cmonr/Robotics-BoosterPack/README.md

Robotics-BoosterPack
====================

Robotics BoosterPack for the Tiva Launchpad

For lack of a better place, the Mouser BoM: 
[Mouser BoM](http://www.mouser.com/ProjectManager/ProjectDetail.aspx?AccessID=04738dc8be)
