cmonr/Robotics-BoosterPack/schematic.png

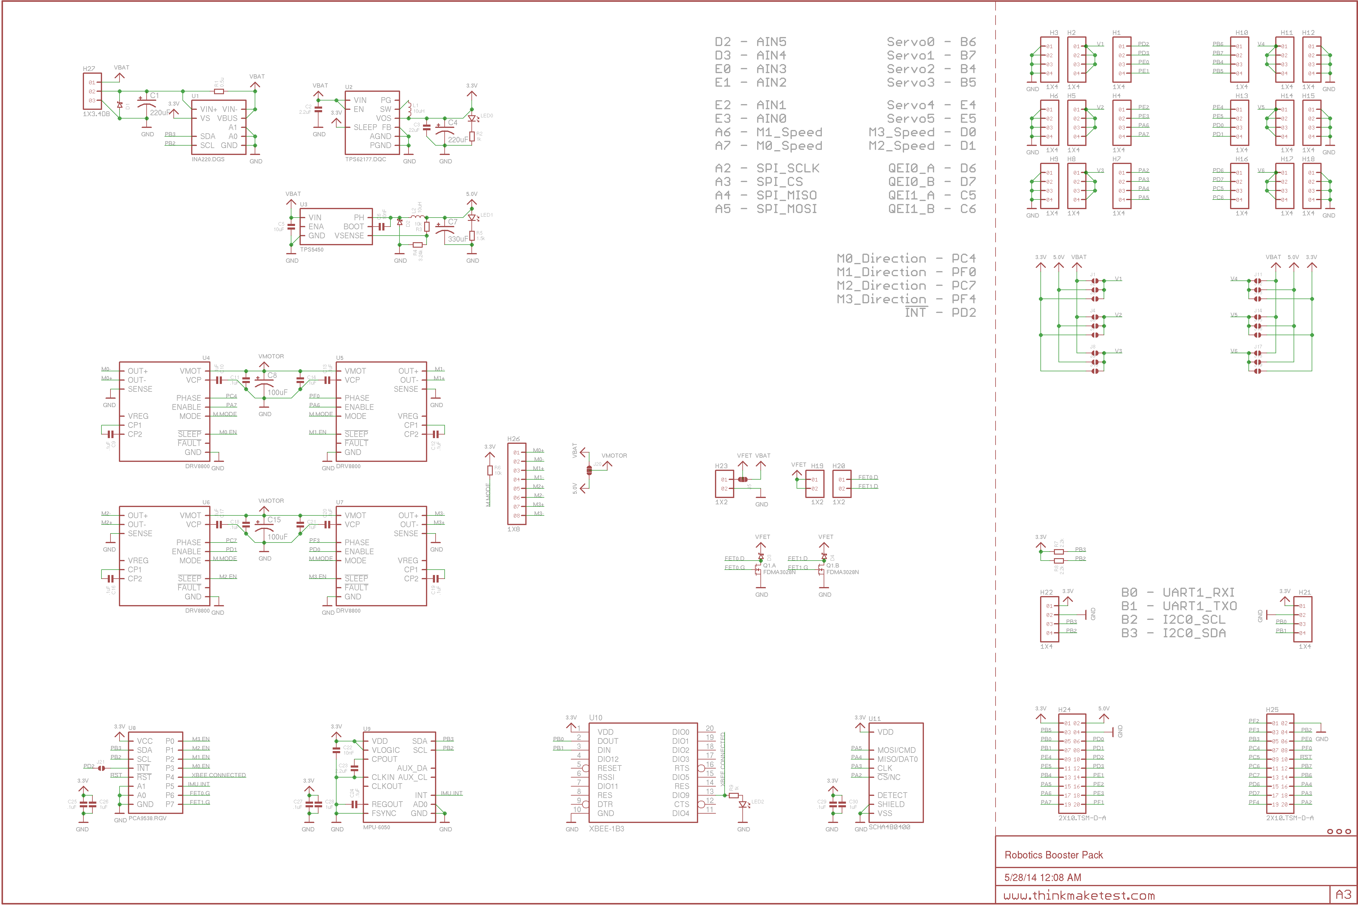
schematic.png
