cmonr/Robotics-BoosterPack/Robotics Booster Pack.dxf

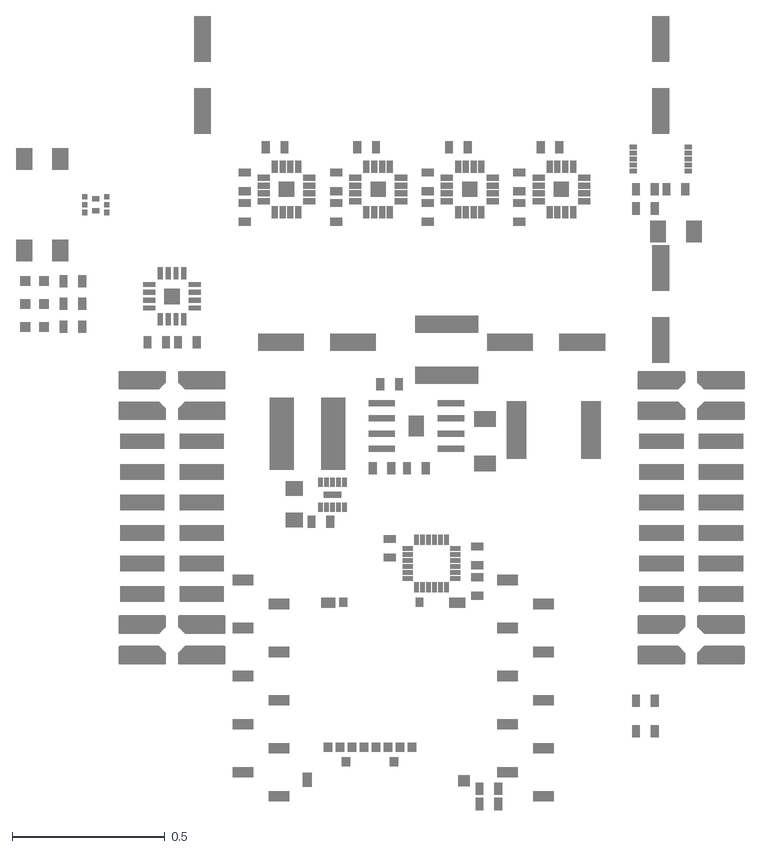
[picture p2: CAD file, 2014-06-07]
Robotics Booster Pack.dxf
2.38 x 2.60
