cmonr/Robotics-BoosterPack/Robotics Booster Pack.brd

## EAGLE design Robotics Booster Pack.brd (2014-05-28)

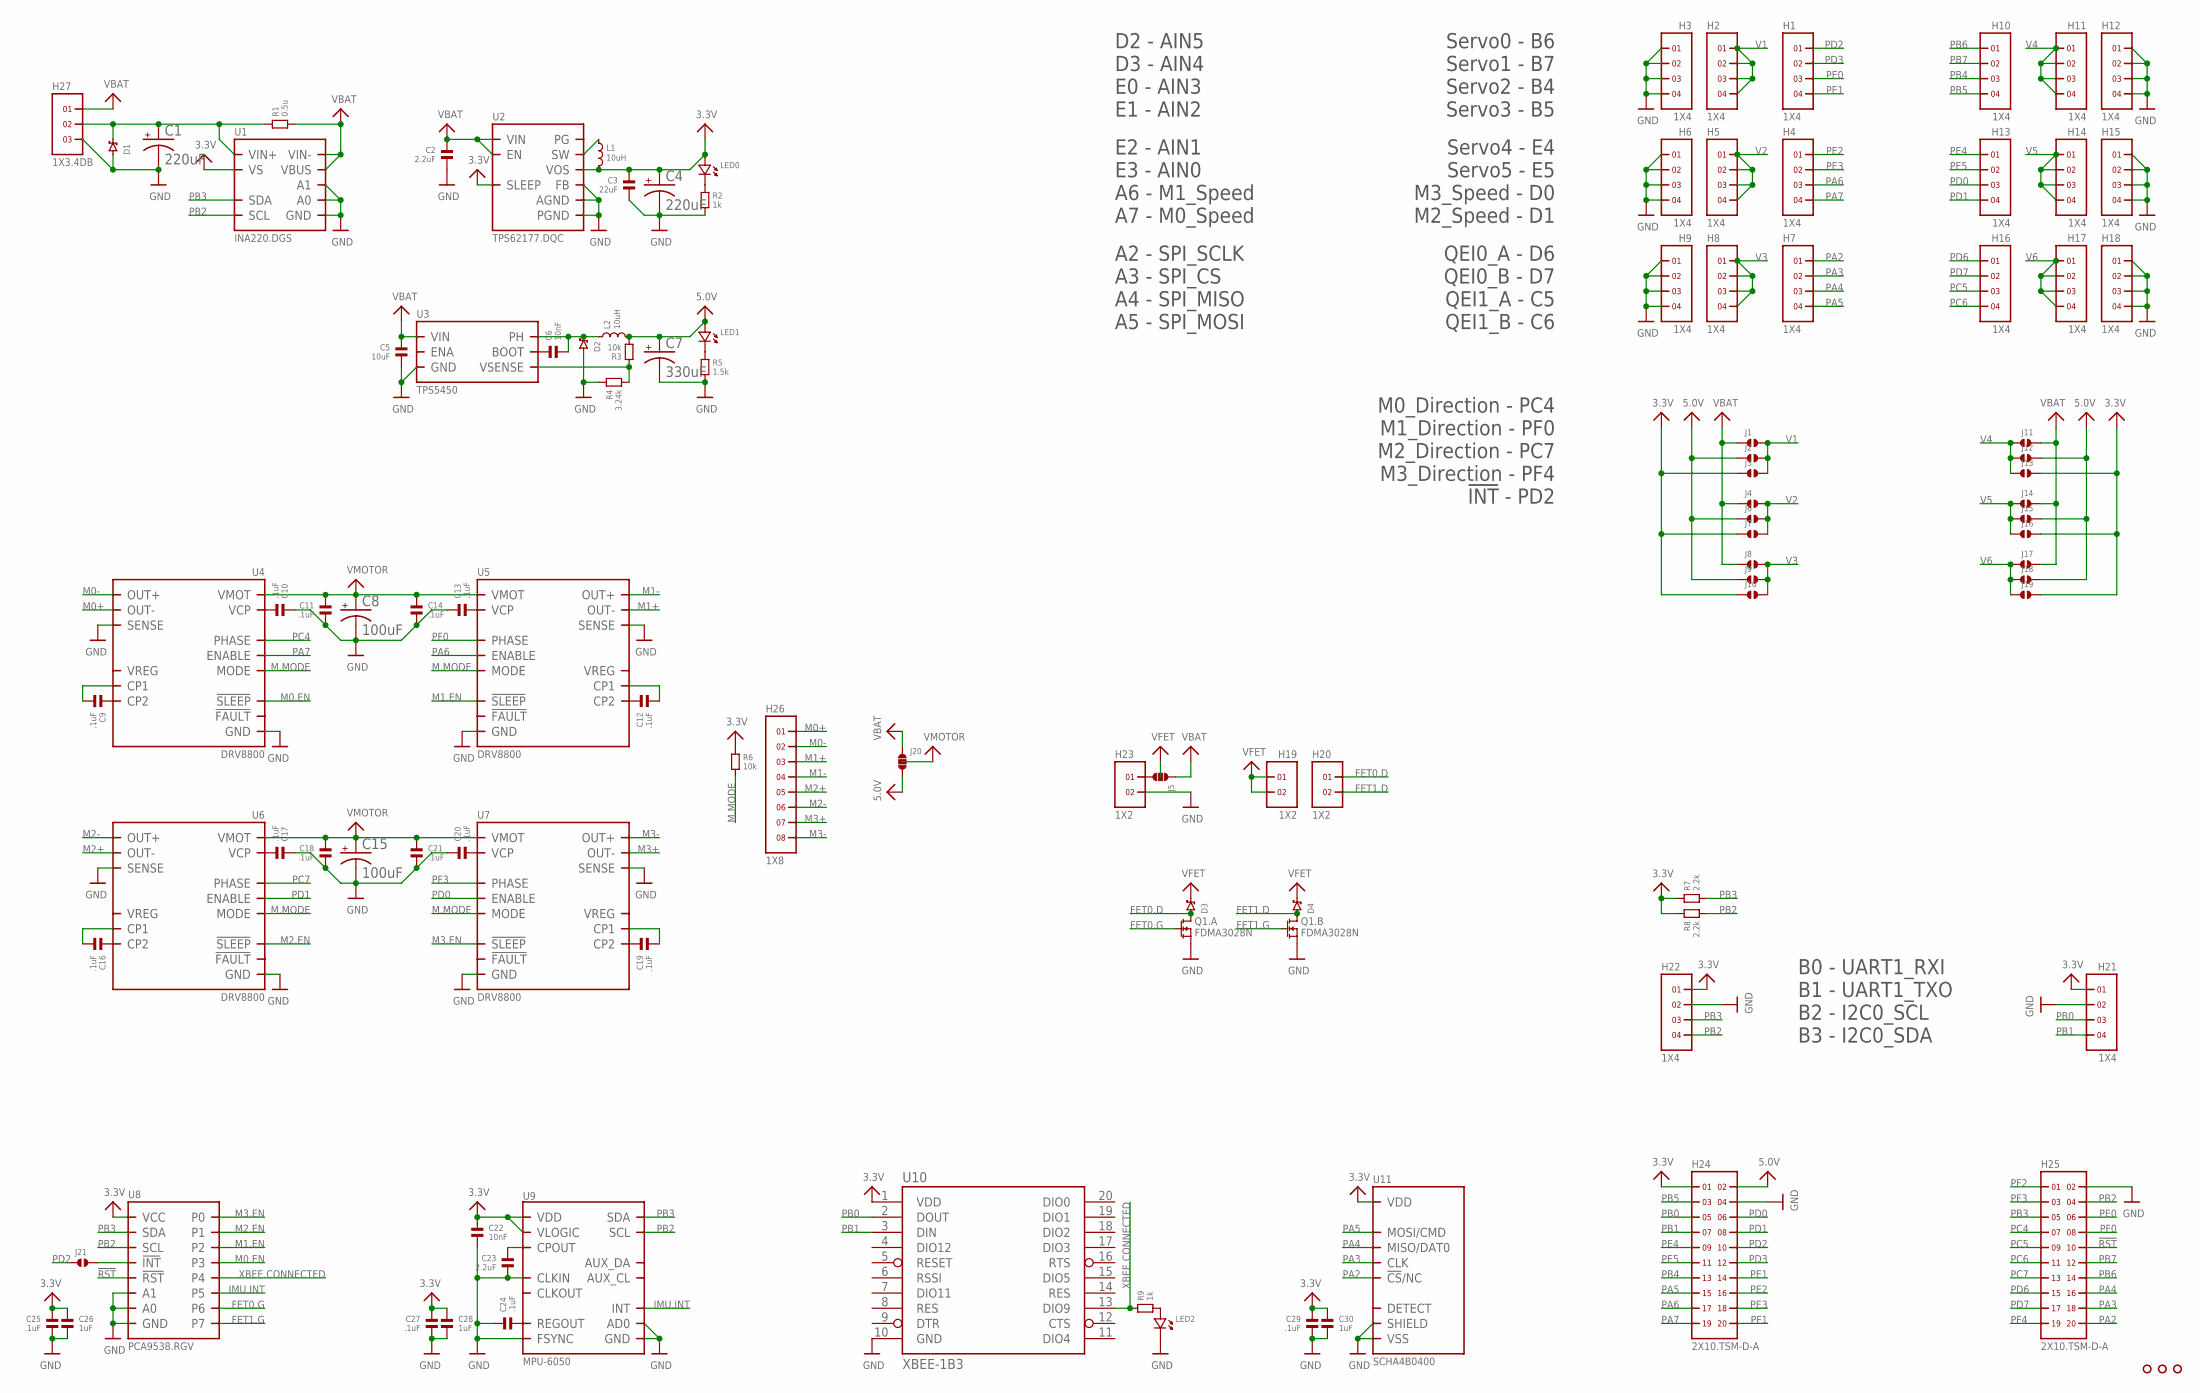
[picture p3: schematic Robotics Booster Pack.sch]

Parts:
C1, C4: 220uF; PANASONIC_E
C2, C23: 2.2uF; 0603
C3: 22uF; 0805
C5: 10uF; 1206
C6, C22: 10nF; 0603
C7: 330uF; PANASONIC_E
C8, C15: 100uF; PANASONIC_E
C9, C10, C11, C12, C13, C14, C16, C17, C18, C19, C20, C21, C24, C25, C27, C29: .1uF; 0603
C26, C28, C30: 1uF; 0603
D1, D3, D4: CDBMT2100-HF; SOD-123H
D2: CDBC5XXX-G; DO-214AB
H1, H2, H3, H4, H5, H6, H7, H8, H9, H10, H11, H12, H13, H14, H15, H16, H17, H18, H21, H22: 1X4
H19, H20, H23: 1X2
H24, H25: 2X10.TSM-D-A; TSM-110-XX-XXX-DV-A
H26: 1X8; 1824480000
H27: 1X3.4DB; 4DB-P108-02
J1, J2, J4, J6, J8, J9, J11, J13, J14, J15, J17, J18, J21: SOLDERJUMPER.2.LRG; 2.LRG
J3, J7, J10, J12, J16, J19: SOLDERJUMPER.2.LRG.PASTE; 2.LRG.PASTE
J5, J20: SOLDERJUMPER.3.LRG.12; 3.LRG.12
L1: 10uH; SRN6045
L2: 10uH; XAL6060
LED0, LED1, LED2: LED.0603; 0603.LED
Q1: FDMA3028N; MICROFET.2X2
R1: 0.5u; 2512
R2, R9: 1k; 0603
R3, R6: 10k; 0603
R4: 3.24k; 0603
R5: 1.5k; 0603
R7, R8: 2.2k; 0603
U1: INA220.DGS; DGS.10
U2: TPS62177.DQC; DQC
U3: TPS5450; DDA
U4, U5, U6, U7: DRV8800; RTY.16
U8: PCA9538.RGV; RGV.16
U9: MPU-6050; QFN.24.4X4
U10: XBEE-1B3; XBEE-SMD
U11: SCHA4B0400
U$3, U$4, U$21: HOLE.4MM; #4

Connections:
3.3V: C3.1, C4.+, C22.1, C25.1, C26.1, C27.1, C28.1, C29.1, C30.1, H21.1, H22.1, H24.1, J3.1, J7.1, J10.1, J13.1, J16.1, J19.1, L1.2, LED0.P$1 (1), R6.1, R7.1, R8.1, U1.6 (VS), U2.8 (SLEEP), U2.10 (VOS), U8.14 (VCC), U9.8 (VLOGIC), U9.13 (VDD), U10.1 (VDD), U11.VDD
5.0V: C7.+, H24.2, J2.1, J6.1, J9.1, J12.1, J15.1, J18.1, J20.3, L2.2, LED1.P$1 (1), R3.2
!RST: H25.10, U8.1 (!RST)
FET0.D: D3.2, H20.1, Q1.6 (D), Q1.PAD@1 (D)
FET0.G: Q1.2 (G), U8.9 (P6)
FET1.D: D4.2, H20.2, Q1.3 (D), Q1.PAD@2 (D)
FET1.G: Q1.5 (G), U8.10 (P7)
GND: C1.-, C2.2, C3.2, C4.-, C5.2, C7.-, C8.-, C10.1, C11.2, C13.1, C14.2, C15.-, C17.1, C18.2, C20.1, C21.2, C22.2, C23.2, C24.1, C25.2, C26.2, C27.2, C28.2, C29.2, C30.2, D1.2, D2.2, H3.1, H3.2, H3.3, H3.4, H6.1, H6.2, H6.3, H6.4, H9.1, H9.2, H9.3, H9.4, H12.1, H12.2, H12.3, H12.4, H15.1, H15.2, H15.3, H15.4, H18.1, H18.2, H18.3, H18.4, H21.2, H22.2, H23.2, H24.4, H25.2, H27.3, LED2.P$2 (2), Q1.1 (S), Q1.4 (S), R2.2, R4.1, R5.2, U1.1 (A1), U1.2 (A0), U1.7 (GND), U2.1 (PGND), U2.5 (FB), U2.6 (AGND), U2.PAD (PGND), U3.6 (GND), U3.PAD (GND), U4.2 (GND), U4.7 (SENSE), U4.12 (GND), U4.PAD (GND), U5.2 (GND), U5.7 (SENSE), U5.12 (GND), U5.PAD (GND), U6.2 (GND), U6.7 (SENSE), U6.12 (GND), U6.PAD (GND), U7.2 (GND), U7.7 (SENSE), U7.12 (GND), U7.PAD (GND), U8.6 (GND), U8.15 (A0), U8.16 (A1), U8.PAD (GND), U9.1 (CLKIN), U9.9 (AD0), U9.11 (FSYNC), U9.18 (GND), U10.10 (GND), U11.GND (VSS), U11.GND@1 (VSS), U11.GND@2 (VSS), U11.SHIELD, U11.SHIELD@1 (SHIELD), U11.SHIELD@2 (SHIELD), U11.SHIELD@3 (SHIELD), U11.VSS
IMU.INT: U8.8 (P5), U9.12 (INT)
M0+: H26.1@1 (1), H26.1@2 (1), U4.9 (OUT-)
M0-: H26.2@1 (2), H26.2@2 (2), U4.6 (OUT+)
M0.EN: U4.3 (!SLEEP), U8.5 (P3)
M1+: H26.3@1 (3), H26.3@2 (3), U5.9 (OUT-)
M1-: H26.4@1 (4), H26.4@2 (4), U5.6 (OUT+)
M1.EN: U5.3 (!SLEEP), U8.4 (P2)
M2+: H26.5@1 (5), H26.5@2 (5), U6.9 (OUT-)
M2-: H26.6@1 (6), H26.6@2 (6), U6.6 (OUT+)
M2.EN: U6.3 (!SLEEP), U8.3 (P1)
M3+: H26.7@1 (7), H26.7@2 (7), U7.9 (OUT-)
M3-: H26.8@1 (8), H26.8@2 (8), U7.6 (OUT+)
M3.EN: U7.3 (!SLEEP), U8.2 (P0)
M.MODE: R6.2, U4.16 (MODE), U5.16 (MODE), U6.16 (MODE), U7.16 (MODE)
unnamed: L1.1, U2.9 (SW)
unnamed: LED0.P$2 (2), R2.1
unnamed: LED1.P$2 (2), R5.1
unnamed: LED2.P$1 (1), R9.2
unnamed: H23.1, J5.3
unnamed: C24.2, U9.10 (REGOUT)
unnamed: J21.2, U8.11 (!INT)
unnamed: C9.1, U4.11 (CP2)
unnamed: C10.2, U4.13 (VCP)
unnamed: C13.2, U5.13 (VCP)
unnamed: C17.2, U6.13 (VCP)
unnamed: C20.2, U7.13 (VCP)
unnamed: C1.+, D1.1, H27.2, R1.1, U1.10 (VIN+)
unnamed: C23.1, U9.20 (CPOUT)
unnamed: C12.1, U5.11 (CP2)
unnamed: C16.1, U6.11 (CP2)
unnamed: C19.1, U7.11 (CP2)
unnamed: C6.1, U3.1 (BOOT)
unnamed: C6.2, D2.1, L2.1, U3.8 (PH)
unnamed: R3.1, R4.2, U3.4 (VSENSE)
unnamed: C16.2, U6.10 (CP1)
unnamed: C9.2, U4.10 (CP1)
unnamed: C12.2, U5.10 (CP1)
unnamed: C19.2, U7.10 (CP1)
PA2: H7.1, H25.20, U11.!CS!/NC/DAT3 (!CS!/NC)
PA3: H7.2, H25.18, U11.CLK
PA4: H7.3, H25.16, U11.MISO/DAT0
PA5: H7.4, H24.15, U11.MOSI/CMD
PA6: H4.3, H24.17, U5.4 (ENABLE)
PA7: H4.4, H24.19, U4.4 (ENABLE)
PB0: H21.3, H24.5, U10.2 (DOUT)
PB1: H21.4, H24.7, U10.3 (DIN)
PB2: H22.4, H25.4, R8.2, U1.5 (SCL), U8.12 (SCL), U9.23 (SCL)
PB3: H22.3, H25.5, R7.2, U1.4 (SDA), U8.13 (SDA), U9.24 (SDA)
PB4: H10.3, H24.13
PB5: H10.4, H24.3
PB6: H10.1, H25.14
PB7: H10.2, H25.12
PC4: H25.7, U4.1 (PHASE)
PC5: H16.3, H25.9
PC6: H16.4, H25.11
PC7: H25.13, U6.1 (PHASE)
PD0: H13.3, H24.6, U7.4 (ENABLE)
PD1: H13.4, H24.8, U6.4 (ENABLE)
PD2: H1.1, H24.10, J21.1
PD3: H1.2, H24.12
PD6: H16.1, H25.15
PD7: H16.2, H25.17
PE0: H1.3, H25.6
PE1: H1.4, H24.14
PE2: H4.1, H24.16
PE3: H4.2, H24.18
PE4: H13.1, H24.9
PE5: H13.2, H24.11
PF0: H25.8, U5.1 (PHASE)
PF1: H24.20
PF2: H25.1
PF3: H25.3, U7.1 (PHASE)
PF4: H25.19
V1: H2.1, H2.2, H2.3, H2.4, J1.2, J2.2, J3.2
V2: H5.1, H5.2, H5.3, H5.4, J4.2, J6.2, J7.2
V3: H8.1, H8.2, H8.3, H8.4, J8.2, J9.2, J10.2
V4: H11.1, H11.2, H11.3, H11.4, J11.2, J12.2, J13.2
V5: H14.1, H14.2, H14.3, H14.4, J14.2, J15.2, J16.2
V6: H17.1, H17.2, H17.3, H17.4, J17.2, J18.2, J19.2
VBAT: C2.1, C5.1, H27.1, J1.1, J4.1, J5.1, J8.1, J11.1, J14.1, J17.1, J20.1, R1.2, U1.8 (VBUS), U1.9 (VIN-), U2.2 (VIN), U2.3 (EN), U3.7 (VIN)
VFET: D3.1, D4.1, H19.1, H19.2, J5.2
VMOTOR: C8.+, C11.1, C14.1, C15.+, C18.1, C21.1, J20.2, U4.8 (VMOT), U5.8 (VMOT), U6.8 (VMOT), U7.8 (VMOT)
XBEE.CONNECTED: R9.1, U8.7 (P4), U10.13 (DIO9)

Notes on the sheet:
D2 - AIN5 D3 - AIN4 E0 - AIN3 E1 - AIN2
E2 - AIN1 E3 - AIN0 A6 - M1_Speed A7 - M0_Speed
A2 - SPI_SCLK A3 - SPI_CS A4 - SPI_MISO A5 - SPI_MOSI
Servo0 - B6 Servo1 - B7 Servo2 - B4 Servo3 - B5
Servo4 - E4 Servo5 - E5 M3_Speed - D0 M2_Speed - D1
QEI0_A - D6 QEI0_B - D7 QEI1_A - C5 QEI1_B - C6
B0 - UART1_RXI B1 - UART1_TXO B2 - I2C0_SCL B3 - I2C0_SDA
M0_Direction - PC4 M1_Direction - PF0 M2_Direction - PC7 M3_Direction - PF4 !INT! - PD2

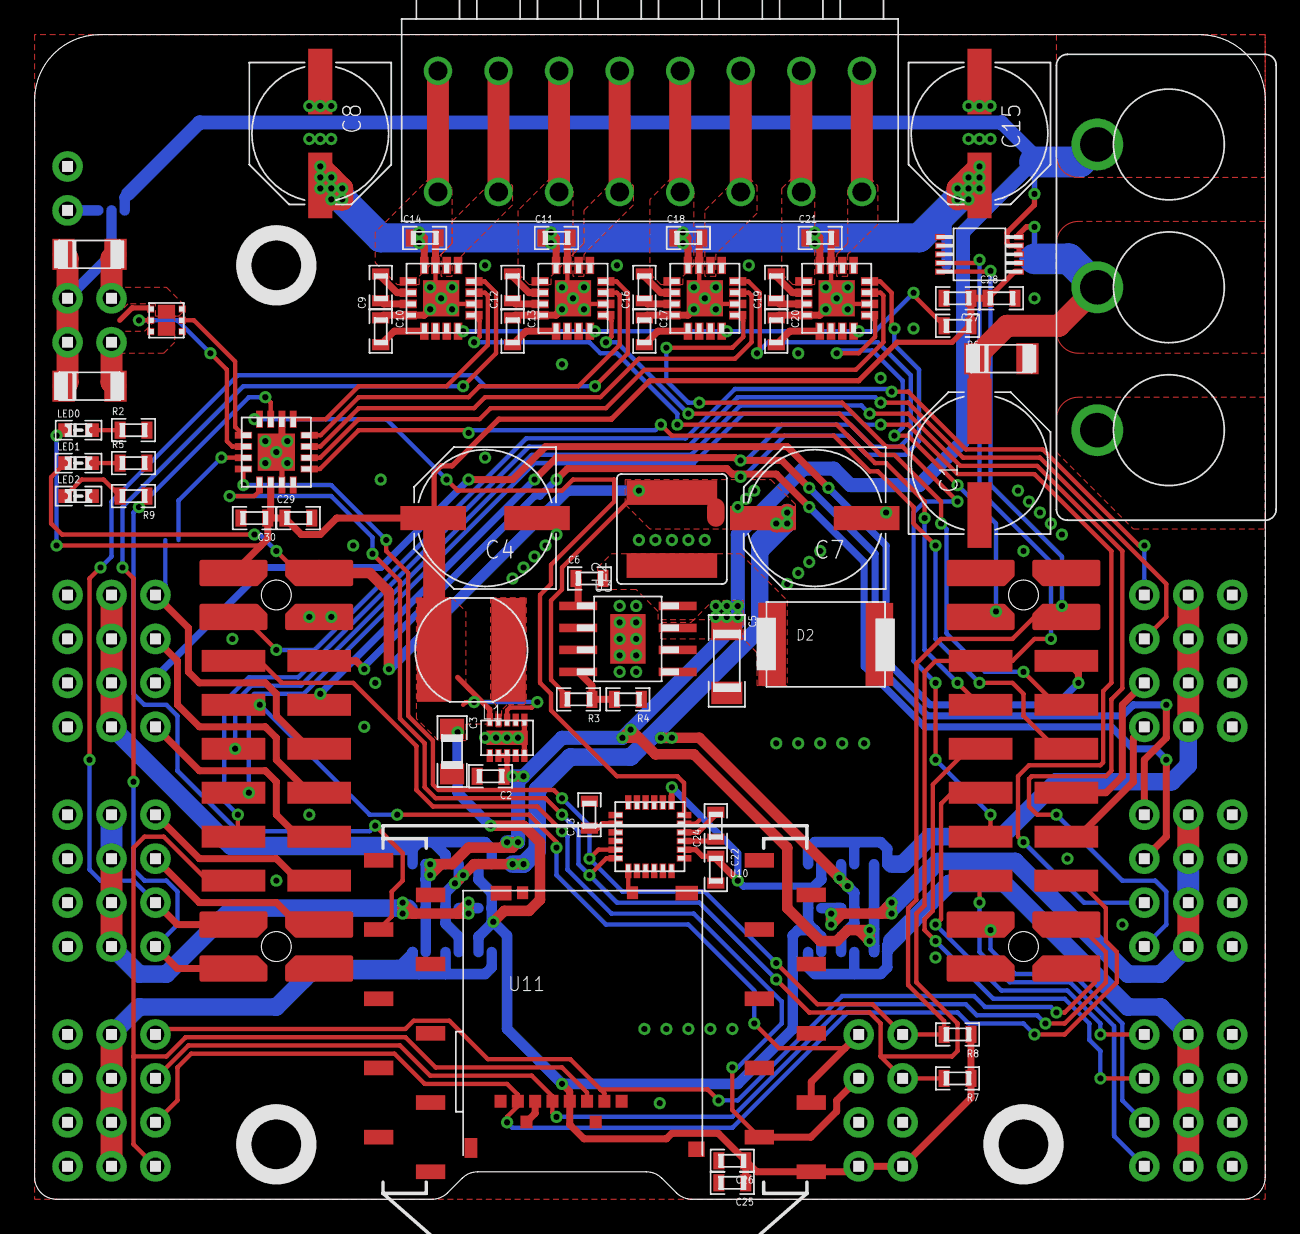
[picture p4: board Robotics Booster Pack.brd from above]

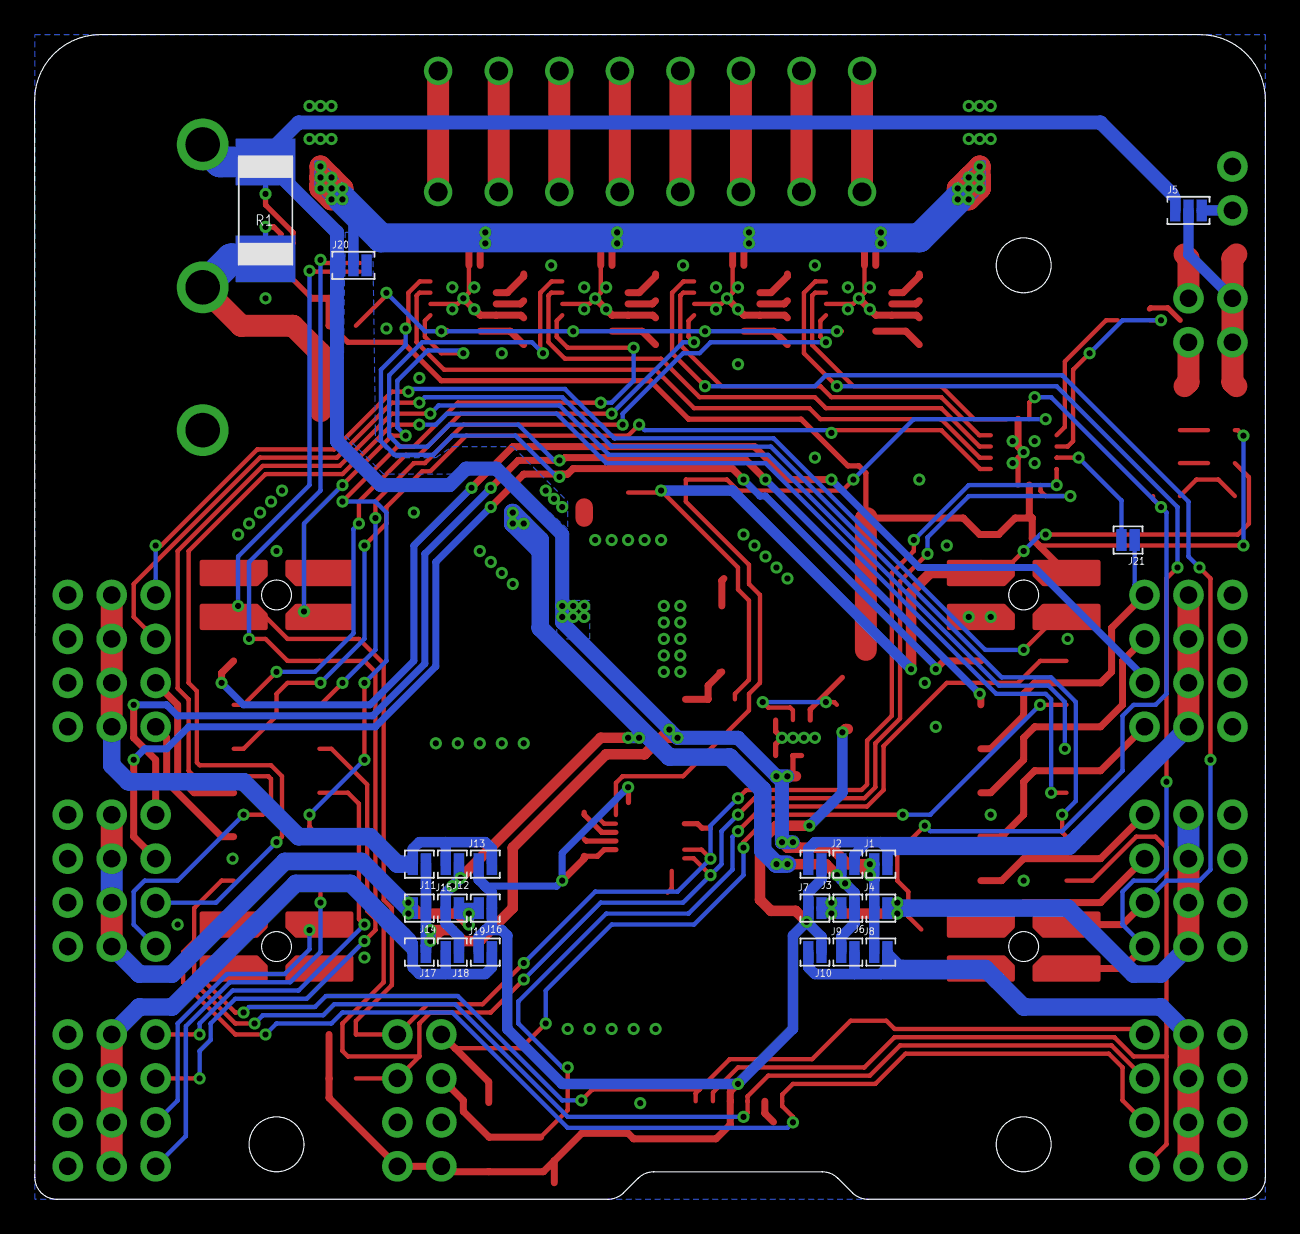
[picture p5: board Robotics Booster Pack.brd from below]

Board: 2 copper layers, 71.1 x 67.3 mm, 111 parts (22 on the bottom side), 88 nets.
