cmonr/Robotics-BoosterPack/Robot Board ++.brd

## EAGLE design Robot Board ++.brd (2013-05-02)

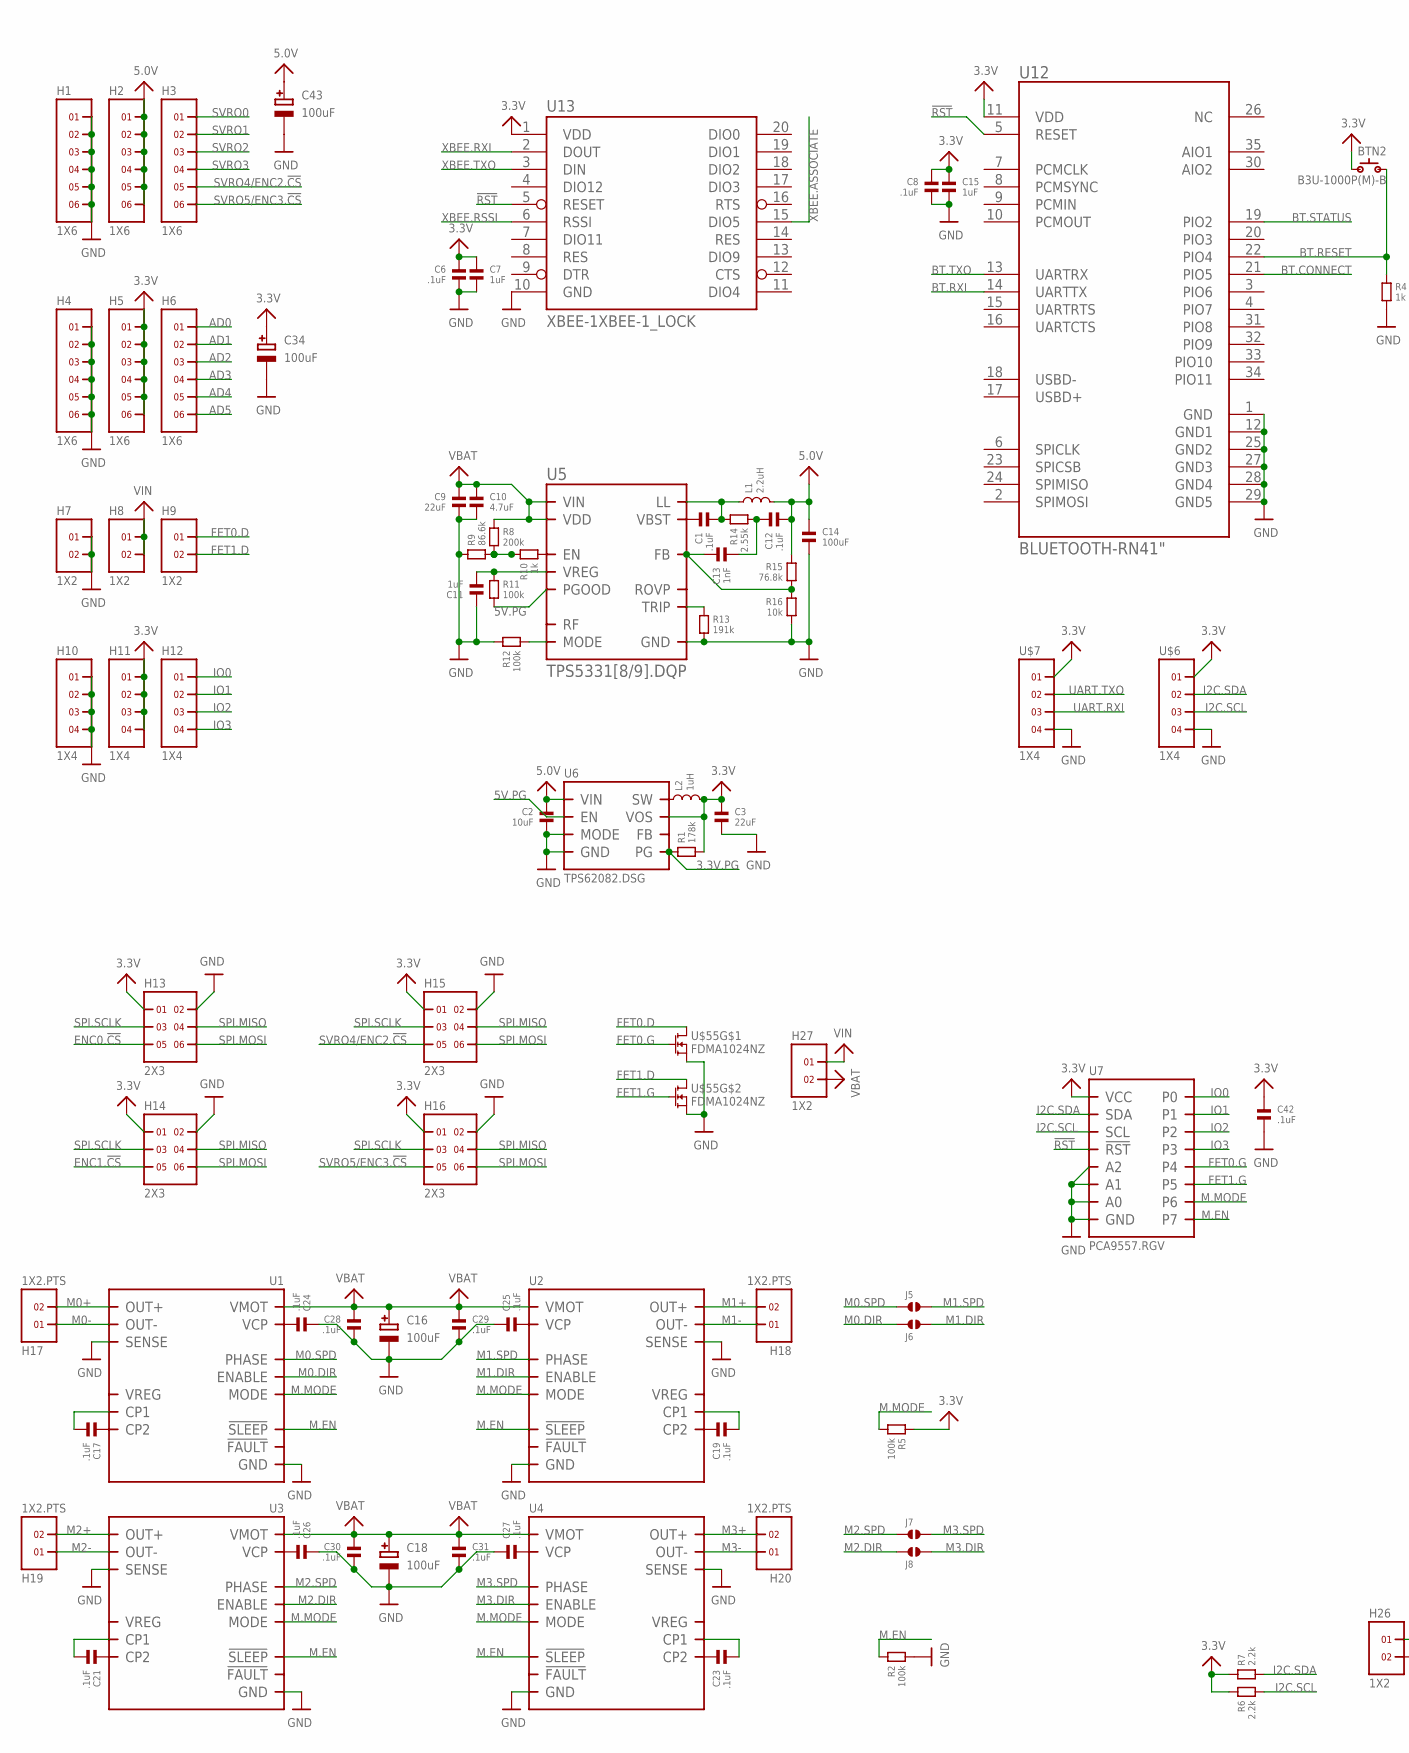
[picture p6: schematic Robot Board ++.sch, part in row 1, column 1]

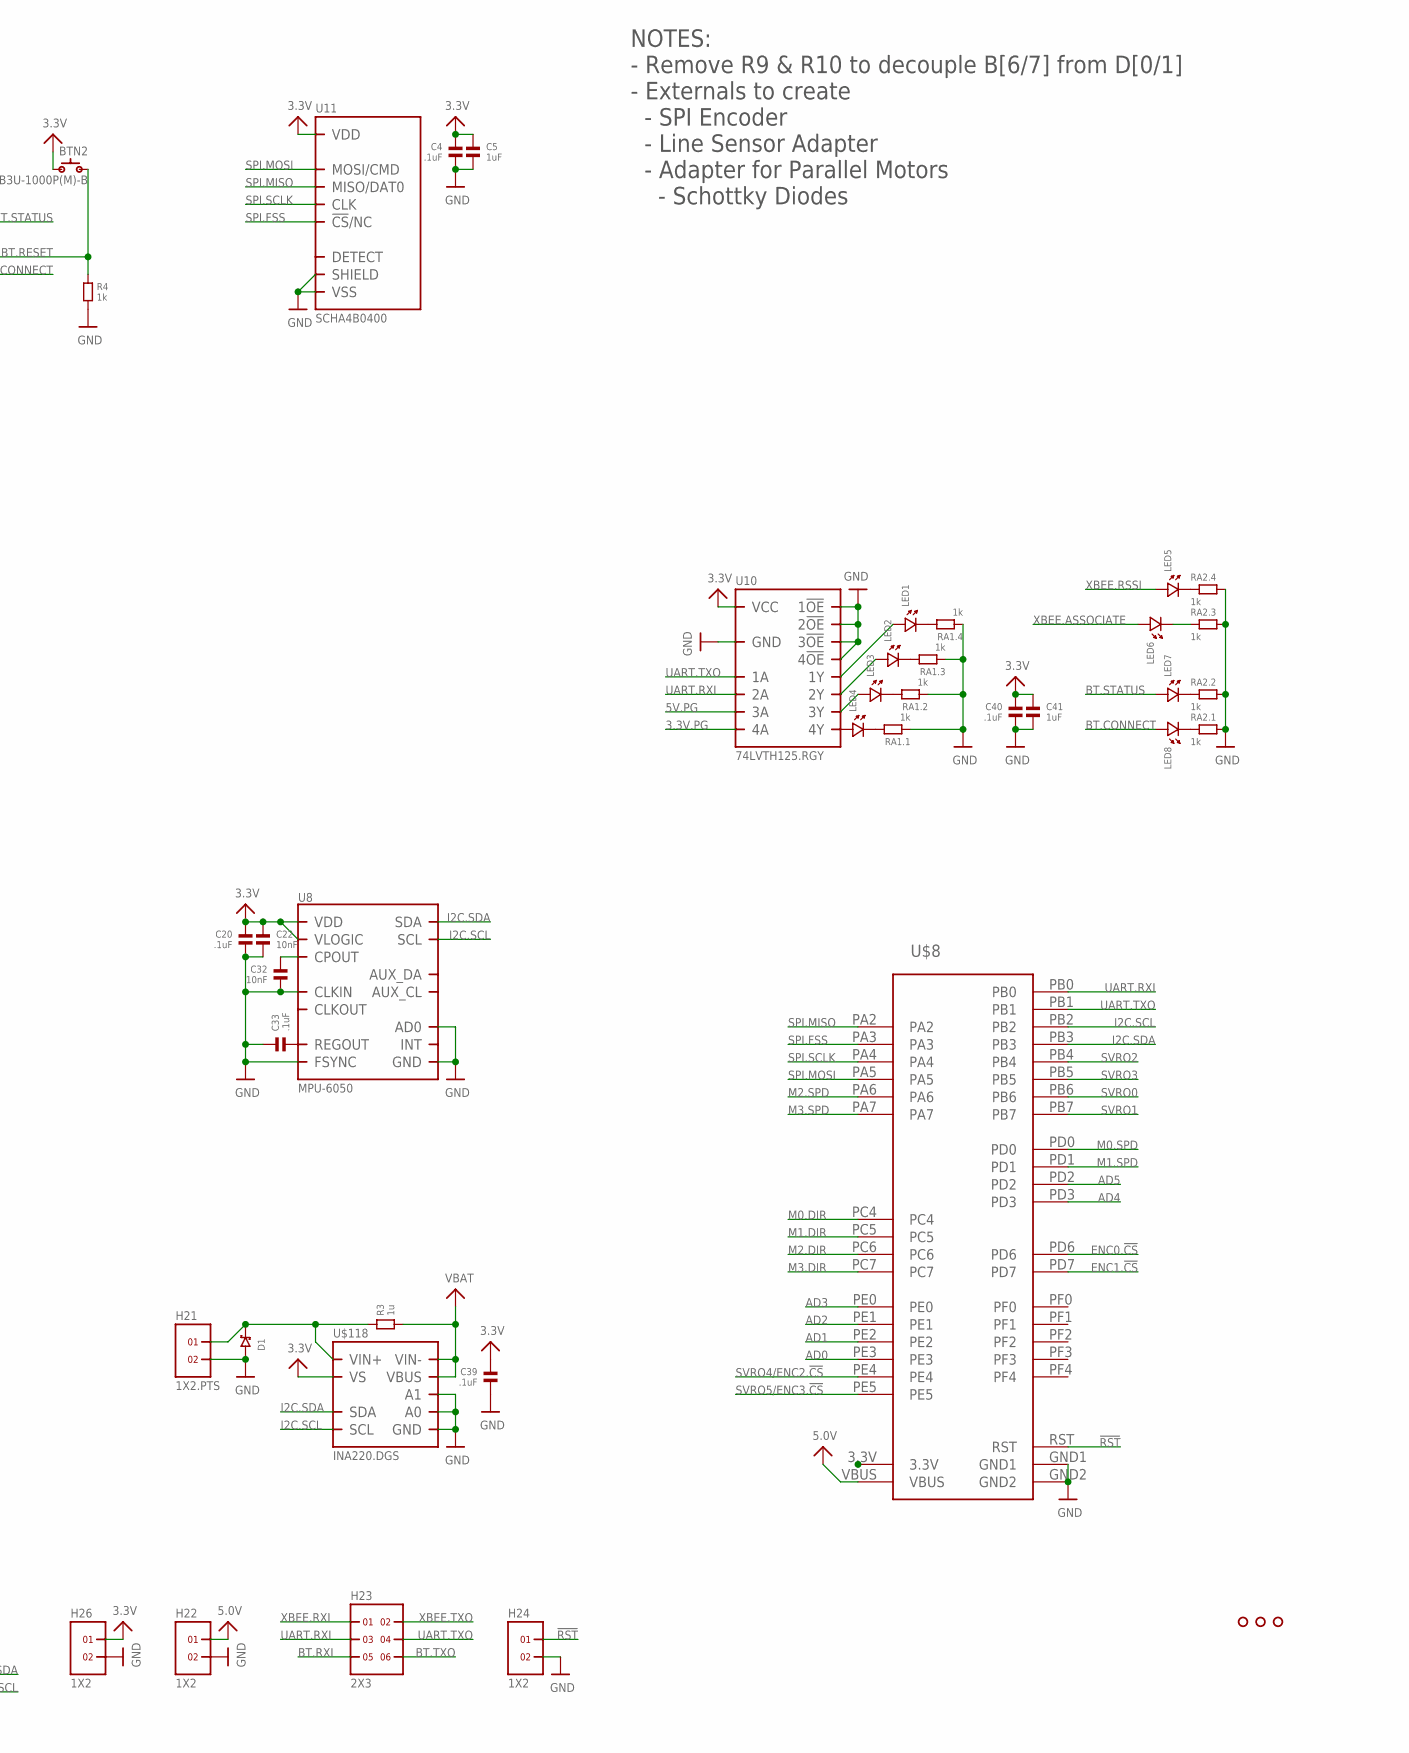
[picture p7: schematic Robot Board ++.sch, part in row 1, column 2]

Parts:
BTN2: B3U-1000P(M)-B
C1, C4, C6, C8, C12, C17, C19, C20, C21, C23, C24, C25, C26, C27, C28, C29, C30, C31, C33, C39, C40, C42: .1uF; 0603
C2: 10uF; 0603
C3: 22uF; 0603
C5, C7, C11, C15, C41: 1uF; 0603
C9: 22uF; 1206
C10: 4.7uF; 0805
C13: 1nF; 0603
C14: 100uF; 1210
C16, C18, C34, C43: 100uF; PANASONIC_C
C22, C32: 10nF; 0603
D1: DIODE[SCHOTKY]-SOD123W; SOD123W
H1, H2, H3, H4, H5, H6: 1X6
H7, H8, H9, H22, H24, H26, H27: 1X2
H10, H11, H12: 1X4
H13, H14, H15, H16: 2X3; 2X3@1
H17, H18, H19, H20, H21: 1X2.PTS; PTS.PLUG
H23: 2X3
J5, J6, J7, J8: SOLDERJUMPER.2.LRG; 2.LRG
L1: 2.2uH; XAL6030
L2: 1uH; SRN3015
LED1, LED2, LED3, LED4, LED5, LED6, LED7, LED8: LED.0603; 0603.LED
R1: 178k; 0603
R2, R5, R11, R12: 100k; 0603
R3: 1u; 0612
R4, R10: 1k; 0603
R6, R7: 2.2k; 0603
R8: 200k; 0603
R9: 86.6k; 0603
R13: 191k; 0603
R14: 2.55k; 0603
R15: 76.8k; 0603
R16: 10k; 0603
RA1, RA2: 1k; 0603.4.C
U1, U2, U3, U4: DRV8800.RTY; RTY.16
U5: TPS5331[8/9].DQP; DQP.22
U6: TPS62082.DSG; DSG
U7: PCA9557.RGV; RGV.16
U8: MPU-6050; QFN.24.4X4
U10: 74LVTH125.RGY; RGY.14
U11: SCHA4B0400
U12: BLUETOOTH-RN41"; RN41
U13: XBEE-1XBEE-1_LOCK; XBEE-1_LOCK
U$3, U$4, U$11: HOLE.4MM; 4MM
U$6, U$7: 1X4
U$8: STELLARIS-LAUNCHPADSTELLARIS-LAUNCHPAD-XL; LAUNCHPAD-XL
U$55: FDMA1024NZ; MICROFET.2X2
U$118: INA220.DGS; DGS.10

Connections:
3.3V: BTN2.2, C3.1, C4.1, C5.1, C6.1, C7.1, C8.1, C15.1, C20.1, C22.1, C34.+, C39.1, C40.1, C41.1, C42.1, H5.1, H5.2, H5.3, H5.4, H5.5, H5.6, H11.1, H11.2, H11.3, H11.4, H13.1, H14.1, H15.1, H16.1, H26.1, L2.2, R1.2, R5.1, R6.1, R7.1, U6.5 (VOS), U7.14 (VCC), U8.8 (VLOGIC), U8.13 (VDD), U10.14 (VCC), U11.VDD, U12.11 (VDD), U13.1 (VDD), U$6.1, U$7.1, U$118.6 (VS)
3.3V.PG: R1.1, U6.6 (PG), U10.12 (4A)
5.0V: C2.1, C12.2, C14.1, C43.+, H2.1, H2.2, H2.3, H2.4, H2.5, H2.6, H22.1, L1.2, R15.1, U6.8 (VIN), U$8.VBUS
5V.PG: R11.2, U5.3 (PGOOD), U6.1 (EN), U10.9 (3A)
!RST: H24.1, U7.13 (!RST), U12.5 (RESET), U13.5 (RESET), U$8.RST
AD0: H6.1, U$8.PE3
AD1: H6.2, U$8.PE2
AD2: H6.3, U$8.PE1
AD3: H6.4, U$8.PE0
AD4: H6.5, U$8.PD3
AD5: H6.6, U$8.PD2
BT.CONNECT: LED8.P$1 (1), U12.21 (PIO5)
BT.RESET: BTN2.1, R4.1, U12.22 (PIO4)
BT.RXI: H23.5, U12.14 (UARTTX)
BT.STATUS: LED7.P$1 (1), U12.19 (PIO2)
BT.TXO: H23.6, U12.13 (UARTRX)
ENC0.!CS: H13.5, U$8.PD6
ENC1.!CS: H14.5, U$8.PD7
FET0.D: H9.1, U$55.6 (D), U$55.PAD@1 (D)
FET0.G: U7.9 (P4), U$55.2 (G)
FET1.D: H9.2, U$55.3 (D), U$55.PAD@2 (D)
FET1.G: U7.10 (P5), U$55.5 (G)
GND: C2.2, C3.2, C4.2, C5.2, C6.2, C7.2, C8.2, C9.2, C10.2, C11.1, C14.2, C15.2, C16.-, C18.-, C20.2, C22.2, C24.1, C25.1, C26.1, C27.1, C28.2, C29.2, C30.2, C31.2, C32.2, C33.1, C34.-, C39.2, C40.2, C41.2, C42.2, C43.-, D1.P$1 (1), H1.1, H1.2, H1.3, H1.4, H1.5, H1.6, H4.1, H4.2, H4.3, H4.4, H4.5, H4.6, H7.1, H7.2, H10.1, H10.2, H10.3, H10.4, H13.2, H14.2, H15.2, H16.2, H21.2, H22.2, H24.2, H26.2, R2.2, R4.2, R9.1, R12.1, R13.2, R16.2, RA1.1, RA1.3 (1), RA1.5 (1), RA1.7 (1), RA2.2, RA2.4 (2), RA2.6 (2), RA2.8 (2), U1.2 (GND), U1.7 (SENSE), U1.12 (GND), U1.PAD (GND), U2.2 (GND), U2.7 (SENSE), U2.12 (GND), U2.PAD (GND), U3.2 (GND), U3.7 (SENSE), U3.12 (GND), U3.PAD (GND), U4.2 (GND), U4.7 (SENSE), U4.12 (GND), U4.PAD (GND), U5.PAD (GND), U6.2 (GND), U6.3 (MODE), U6.PAD (GND), U7.1 (A0), U7.2 (A1), U7.3 (A2), U7.6 (GND), U7.PAD (GND), U8.1 (CLKIN), U8.9 (AD0), U8.11 (FSYNC), U8.18 (GND), U10.1 (1!OE), U10.4 (2!OE), U10.7 (GND), U10.10 (3!OE), U10.13 (4!OE), U10.PAD (GND), U11.GND (VSS), U11.GND@1 (VSS), U11.GND@2 (VSS), U11.SHIELD, U11.SHIELD@1 (SHIELD), U11.SHIELD@2 (SHIELD), U11.SHIELD@3 (SHIELD), U11.VSS, U12.1 (GND), U12.12 (GND1), U12.25 (GND2), U12.27 (GND3), U12.28 (GND4), U12.29 (GND5), U13.10 (GND), U$6.4, U$7.4, U$8.GND1, U$8.GND2, U$55.1 (S), U$55.4 (S), U$118.1 (A1), U$118.2 (A0), U$118.7 (GND)
I2C.SCL: R6.2, U7.15 (SCL), U8.23 (SCL), U$6.3, U$8.PB2, U$118.5 (SCL)
I2C.SDA: R7.2, U7.16 (SDA), U8.24 (SDA), U$6.2, U$8.PB3, U$118.4 (SDA)
IO0: H12.1, U7.4 (P0)
IO1: H12.2, U7.5 (P1)
IO2: H12.3, U7.7 (P2)
IO3: H12.4, U7.8 (P3)
M0+: H17.2, U1.6 (OUT+)
M0-: H17.1, U1.9 (OUT-)
M0.DIR: J6.1, U1.4 (ENABLE), U$8.PC4
M0.SPD: J5.1, U1.1 (PHASE), U$8.PD0
M1+: H18.2, U2.6 (OUT+)
M1-: H18.1, U2.9 (OUT-)
M1.DIR: J6.2, U2.4 (ENABLE), U$8.PC5
M1.SPD: J5.2, U2.1 (PHASE), U$8.PD1
M2+: H19.2, U3.6 (OUT+)
M2-: H19.1, U3.9 (OUT-)
M2.DIR: J8.1, U3.4 (ENABLE), U$8.PC6
M2.SPD: J7.1, U3.1 (PHASE), U$8.PA6
M3+: H20.2, U4.6 (OUT+)
M3-: H20.1, U4.9 (OUT-)
M3.DIR: J8.2, U4.4 (ENABLE), U$8.PC7
M3.SPD: J7.2, U4.1 (PHASE), U$8.PA7
M.EN: R2.1, U1.3 (!SLEEP), U2.3 (!SLEEP), U3.3 (!SLEEP), U4.3 (!SLEEP), U7.12 (P7)
M.MODE: R5.2, U1.16 (MODE), U2.16 (MODE), U3.16 (MODE), U4.16 (MODE), U7.11 (P6)
unnamed: C1.1, U5.4 (VBST)
unnamed: R12.2, U5.20 (MODE)
unnamed: C11.2, R11.1, U5.18 (VREG)
unnamed: R13.1, U5.21 (TRIP)
unnamed: LED1.P$1 (1), U10.3 (1Y)
unnamed: C33.2, U8.10 (REGOUT)
unnamed: R10.2, U5.2 (EN)
unnamed: LED8.P$2 (2), RA2.1
unnamed: C13.1, R15.2, R16.1, U5.1 (FB)
unnamed: R8.2, R9.2, R10.1
unnamed: L2.1, U6.7 (SW)
unnamed: C17.1, U1.11 (CP2)
unnamed: C12.1, C13.2, R14.2
unnamed: C1.2, L1.1, R14.1, U5.6 (LL), U5.7 (LL), U5.8 (LL), U5.9 (LL), U5.10 (LL), U5.11 (LL)
unnamed: C24.2, U1.13 (VCP)
unnamed: C25.2, U2.13 (VCP)
unnamed: C26.2, U3.13 (VCP)
unnamed: C27.2, U4.13 (VCP)
unnamed: D1.P$2 (2), H21.1, R3.1@1 (1), R3.1@2 (1), U$118.10 (VIN+)
unnamed: C32.1, U8.20 (CPOUT)
unnamed: C19.1, U2.11 (CP2)
unnamed: C21.1, U3.11 (CP2)
unnamed: C23.1, U4.11 (CP2)
unnamed: C21.2, U3.10 (CP1)
unnamed: C17.2, U1.10 (CP1)
unnamed: C19.2, U2.10 (CP1)
unnamed: C23.2, U4.10 (CP1)
unnamed: LED2.P$1 (1), U10.6 (2Y)
unnamed: LED4.P$1 (1), U10.11 (4Y)
unnamed: LED7.P$2 (2), RA2.3 (1)
unnamed: LED6.P$2 (2), RA2.5 (1)
unnamed: LED5.P$2 (2), RA2.7 (1)
unnamed: LED4.P$2 (2), RA1.2
unnamed: LED3.P$1 (1), U10.8 (3Y)
unnamed: LED1.P$2 (2), RA1.8 (2)
unnamed: LED2.P$2 (2), RA1.6 (2)
unnamed: LED3.P$2 (2), RA1.4 (2)
SPI.FSS: U11.!CS!/NC/DAT3 (!CS!/NC), U$8.PA3
SPI.MISO: H13.4, H14.4, H15.4, H16.4, U11.MISO/DAT0, U$8.PA2
SPI.MOSI: H13.6, H14.6, H15.6, H16.6, U11.MOSI/CMD, U$8.PA5
SPI.SCLK: H13.3, H14.3, H15.3, H16.3, U11.CLK, U$8.PA4
SVRO0: H3.1, U$8.PB6
SVRO1: H3.2, U$8.PB7
SVRO2: H3.3, U$8.PB4
SVRO3: H3.4, U$8.PB5
SVRO4/ENC2.!CS: H3.5, H15.5, U$8.PE4
SVRO5/ENC3.!CS: H3.6, H16.5, U$8.PE5
UART.RXI: H23.3, U10.5 (2A), U$7.3, U$8.PB0
UART.TXO: H23.4, U10.2 (1A), U$7.2, U$8.PB1
VBAT: C9.1, C10.1, C16.+, C18.+, C28.1, C29.1, C30.1, C31.1, H27.2, R3.2@1 (2), R3.2@2 (2), R8.1, U1.8 (VMOT), U2.8 (VMOT), U3.8 (VMOT), U4.8 (VMOT), U5.12 (VIN), U5.13 (VIN), U5.14 (VIN), U5.15 (VIN), U5.16 (VIN), U5.17 (VIN), U5.19 (VDD), U$118.8 (VBUS), U$118.9 (VIN-)
VIN: H8.1, H8.2, H27.1
XBEE.ASSOCIATE: LED6.P$1 (1), U13.15 (DIO5)
XBEE.RSSI: LED5.P$1 (1), U13.6 (RSSI)
XBEE.RXI: H23.1, U13.2 (DOUT)
XBEE.TXO: H23.2, U13.3 (DIN)

Notes on the sheet:
NOTES: - Remove R9 & R10 to decouple B[6/7] from D[0/1] - Externals to create - SPI Encoder - Line Sensor Adapter - Adapter for Parallel Motors - Schottky Diodes

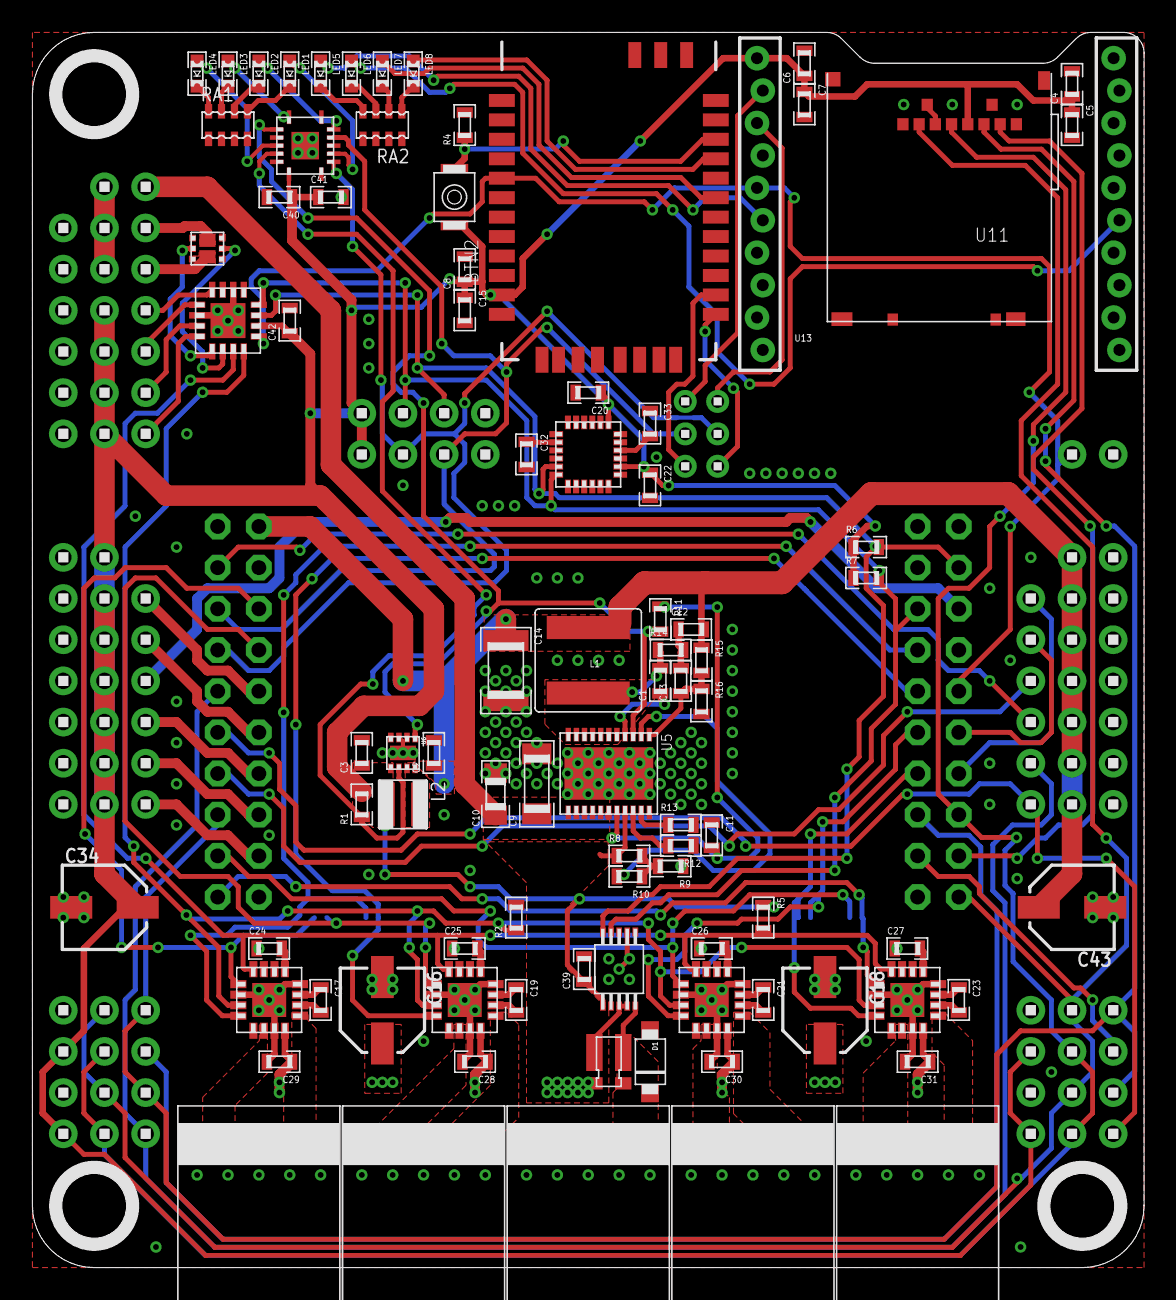
[picture p8: board Robot Board ++.brd from above]

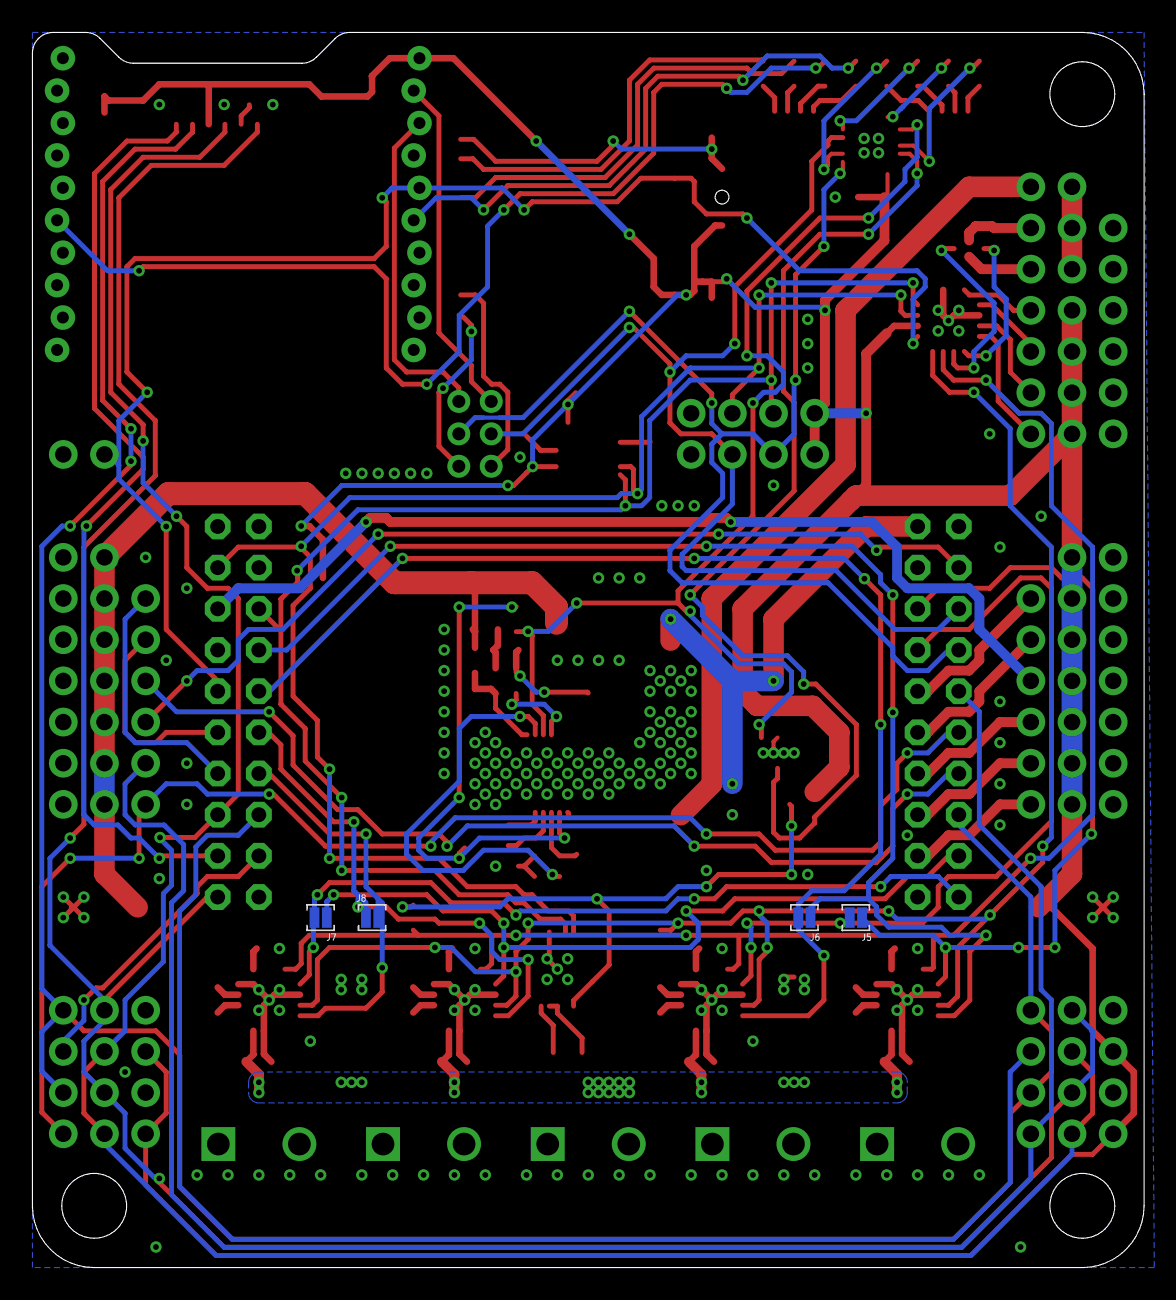
[picture p9: board Robot Board ++.brd from below]

Board: 2 copper layers, 68.6 x 76.2 mm, 119 parts (4 on the bottom side), 102 nets.
