cmonr/Robotics-BoosterPack/(commit log)

2013-05-02 Organizing folders into subdirectories for upcoming projects
    [Robot Board ++.brd, Robot Board ++.sch]
2013-05-03 Renamed files. Corrected uSD Card package. All other ICs check out.
    [Robotics Booster Pack.brd, Robotics Booster Pack.sch]
2013-08-01 Creating base board for Pololu Black Motor Mount
    [Robotics Booster Pack.brd, Robotics Booster Pack.sch]
2013-08-11 Addressed all issues in github repo Moved GPIO & Mosfet connections up because of USB connector in Launchpad Fixed SPI pin swap Added diode between 5v and VBUS Changed jumpers for UART BT/XBee select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
    [Robotics Booster Pack.brd, Robotics Booster Pack.sch]
2013-08-13 Created AS5035 FLoating Encoder
    [Robotics Booster Pack.brd, Robotics Booster Pack.sch]
2013-08-13 Changed Pinouts of BoosterPack * SPI Encoders replaced with QEI * SD Card/SPI interface moved to port F * Motor Control Signals moved to port A
    Layout still needs to be redone...
    [Robotics Booster Pack.brd, Robotics Booster Pack.sch]
2013-08-17 Updated board and schematic previews
2013-08-26 Updated Board Preview
2013-09-10 Started routing v2. And by started, I mean rerouting _everything_
    ... The heck's wrong with me ...
    [Robotics Booster Pack.brd, Robotics Booster Pack.sch]
2013-09-15 Making progress on PCB re-layout. Moved some pins around to make routing _much_ easier, along with the added improvements.
    [Robotics Booster Pack.brd, Robotics Booster Pack.sch]
2013-10-06 Replaced 5v regulator circuit with TPS5450 Added more power options in the form of SMD Jumpers Added IO Expander-controlled Servo FET Swapped positions of XBee and extra IO/FETs to make routing simpl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
    [Robotics Booster Pack.brd, Robotics Booster Pack.sch]
2013-10-24 Modifed Robotics BP regulators, along with a few other things
    [Robotics Booster Pack.brd, Robotics Booster Pack.sch]
2013-10-25 Cleaned up Servo.EN connections and indicator LEDs Routing will soon begin. It's unreasonable to believe that it will all be complete by the end of the weekend, bu some goals aren't meant to be met.
    [Robotics Booster Pack.brd, Robotics Booster Pack.sch]
2013-10-26 Began routing of Robotics BP v2 Bluetooth, XBee, and UART mux routing nearly complete. Started LEDs and IMU routing.
    [Robotics Booster Pack.brd, Robotics Booster Pack.sch]
2013-11-04 More Robotics BP v2 routing. Power regulators routed and completed Most IO Expander signals completely routed
    [Robotics Booster Pack.brd, Robotics Booster Pack.sch]
2013-11-05 More Routing for Robotics Booster Pack v2. Assuming UART0 header is oriented correctly, the top 25% of board is completely routed!
    [Robotics Booster Pack.brd]
2013-11-07 Even more routing! With any luck, all routing will be completed by the end of tomorrow ^^;
    [Robotics Booster Pack.brd]
2013-11-08 Robotics BoosterPack v2 Complete! Still need to double check a few mote things, and clean up the silkscreen.
    [Robotics Booster Pack.brd, Robotics Booster Pack.sch]
2013-11-08 Cleaned up completed Robotics Booster Pack v2. Sent off to OSHPark!
    [Robotics Booster Pack.brd, Robotics Booster Pack.sch]
2013-11-27 Cleaned up part names
    [Robotics Booster Pack.sch]
2014-04-12 Began starting on v2.1 Removed: Bluetooth Module, Servo Enable IC, Buffer IC. Corrected Motor PWM/IO signals issue Centered power ICs
    [Robotics Booster Pack.brd, Robotics Booster Pack.sch]
2014-05-07 Let the carnage that shall be known as v3 begin!
    [Robotics Booster Pack.brd, Robotics Booster Pack.csv, Robotics Booster Pack.dxf, Robotics Booster Pack.sch]
2014-05-08 Continued working on RBP v3 Using TPS62177 for 3.3v regulator circuit, new Vin headers, moving things around.
    [Robotics Booster Pack.brd, Robotics Booster Pack.sch]
2014-05-09 COntinuing work on RBP v3 Added smd headers to replace Launchpad throguh hole headers (more routing space on the bottom) Moved around motor controllers -n- stuff.
    [Robotics Booster Pack.brd, Robotics Booster Pack.sch]
2014-05-10 Continuing RBP v3 rerouting. Figured out desired placement of headers. Thinking of adding FET to control power going out of board (NTMFS4897NFT1G). Need to replace IO expander; might need 16 pins ins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
    [Robotics Booster Pack.brd, Robotics Booster Pack.sch]
2014-05-11 Got everything mostly figured out as to where I want things. Using larger capacitors. Pin header mappings decided on. Routing will be hell... Still need to figure out how to distribute all power vari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
    [Robotics Booster Pack.brd, Robotics Booster Pack.sch]
2014-05-11 Part placement ~90% completed. Started routing. Pin mapping figured out (for the most part).
    [Robotics Booster Pack.brd, Robotics Booster Pack.sch]
2014-05-11 Part placement is mostly complete for RBP v3. Layout coming along. Routing multiple Power Header Options will be difficult...
    [Robotics Booster Pack.brd, Robotics Booster Pack.sch]
2014-05-12 More routing. Completed Motor Controller power traces and 3.3v & 5v regulator power traces.
    [Robotics Booster Pack.brd, Robotics Booster Pack.sch]
2014-05-14 More routing fun! Got a significant amount ofpower signals rounted. Replaced 1W 1mOhm power resistor with 3W 0.5mOhm resistor (able to carry much more current)
    [Robotics Booster Pack.brd, Robotics Booster Pack.sch]
2014-05-17 Board completely routed! Silkscreen needed, and final mulling/triple check needed, but otherwise, it's nearly ready to be made!
    [Robotics Booster Pack.brd, Robotics Booster Pack.sch]
2014-05-17 Robitcs BPv3 cleaned up, with silkscreen added. Ready to be fabricated!
    [Robotics Booster Pack.brd, Robotics Booster Pack.sch]
2014-05-25 Removed .csv file for now
    [Robotics Booster Pack.csv]
2014-05-25 Also removed .dxf (leftover from gerber generation?)
    [Robotics Booster Pack.dxf]
2014-05-28 Exported BoM. Moved around schematic and renamed parts to be contiguous
    [Robotics Booster Pack.brd, Robotics Booster Pack.csv, Robotics Booster Pack.sch]
2014-05-28 Update Robotics Booster Pack.csv
    [Robotics Booster Pack.csv]
2014-05-28 Added link to Mouser BoM
2014-06-07 Added .dxf export for stencil
    [Robotics Booster Pack.dxf]
