cmonr/Robotics-BoosterPack/(notices)

Notices in the files:
parts and their libraries:
SparkFun-RF: Licensing: CC v3.0 Share-Alike You are welcome to use this library for commercial purposes.
microbuilder: This work is placed in the public domain, and may be freely used for commercial and non-commercial work with the following conditions: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
